alexclunan/impedance-analyzer/docs/archive/legacy-plans/memory__MEMORY.md

# Memory Index

- [full_design.bd known non-issues](full-design-bd-known-nonissues.md) — DAC dac_data_y unused & ADC capture-clock CDC are intentional; don't re-flag
