alexclunan/impedance-analyzer/Block Diagrams/FPGA_simplified.png

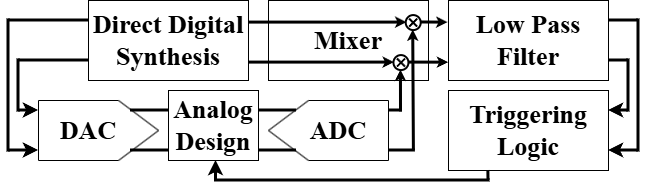
Block Diagrams/FPGA_simplified.png
