alexclunan/impedance-analyzer/Block Diagrams/Top-Level-Architecture-v0.png

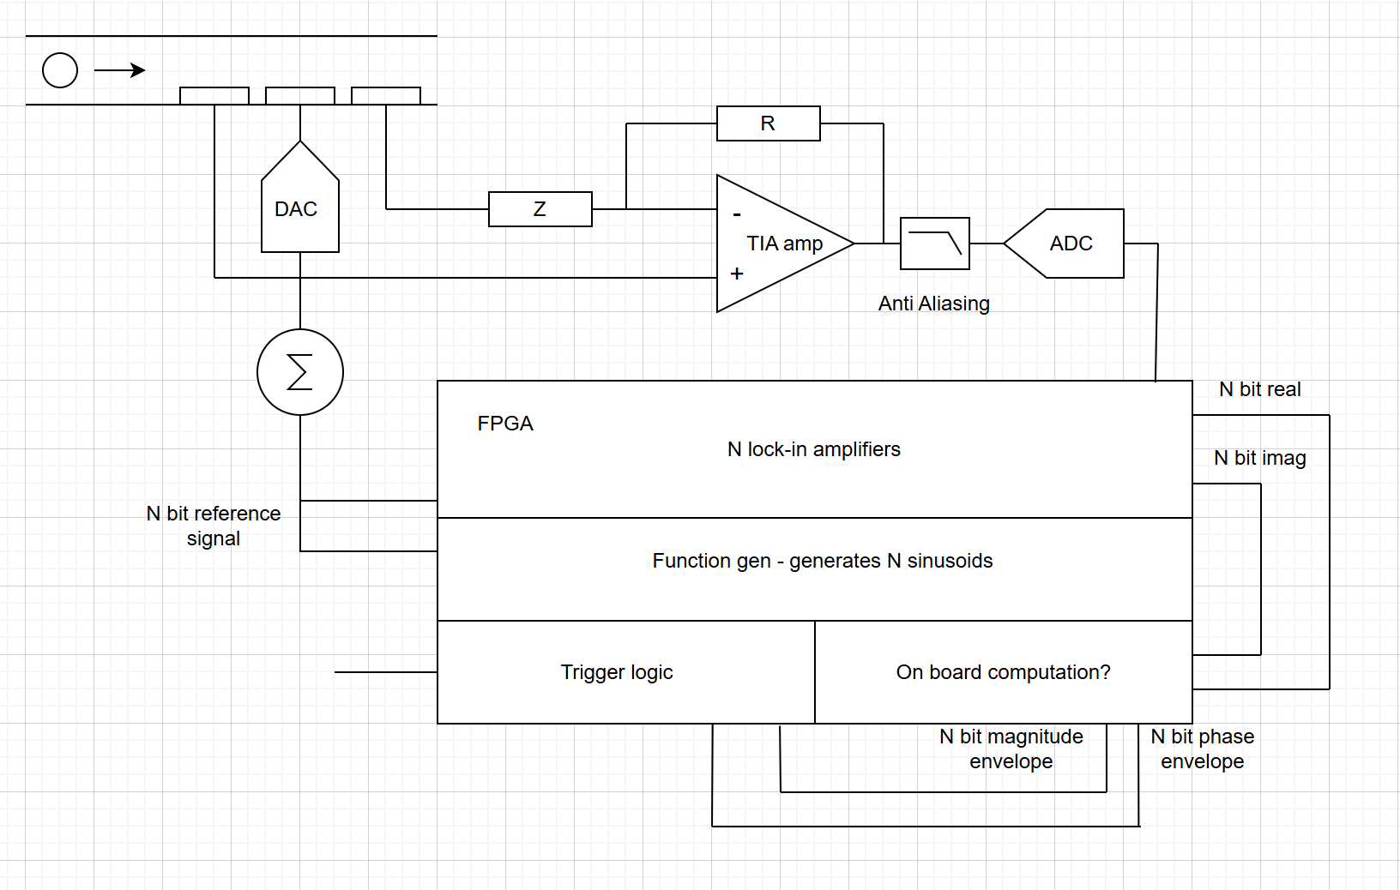
Block Diagrams/Top-Level-Architecture-v0.png
