alexclunan/impedance-analyzer/pc/adc2_spectrum.png

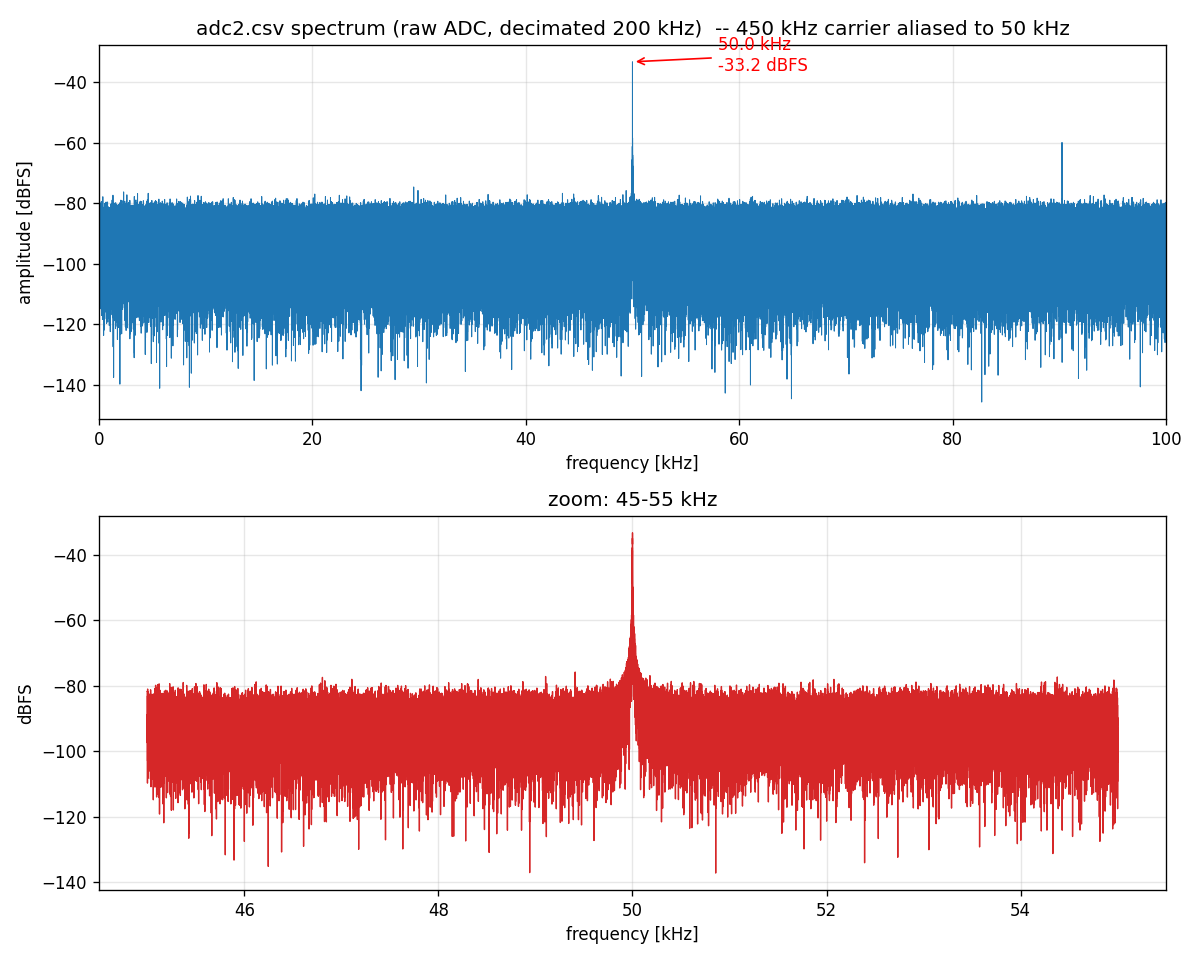
pc/adc2_spectrum.png
