alexclunan/impedance-analyzer/docs/archive/legacy-plans/verification_plans__05_triggering_TODO.md

# 05 — Triggering RTL Block

**Status: DEFERRED.**

The trigger logic (impedance amplitude + phase → sorting decision) already exists as a Python script from a separate project. It will be translated to RTL in a later phase.

No design, approach, or interface recommendations are made at this stage. This document is a placeholder; a full implementation plan will be written when the translation is taken up.

**TODO:** Translate existing Python triggering script to RTL.
