alexclunan/impedance-analyzer/PCB/PCB Schematic.pdf

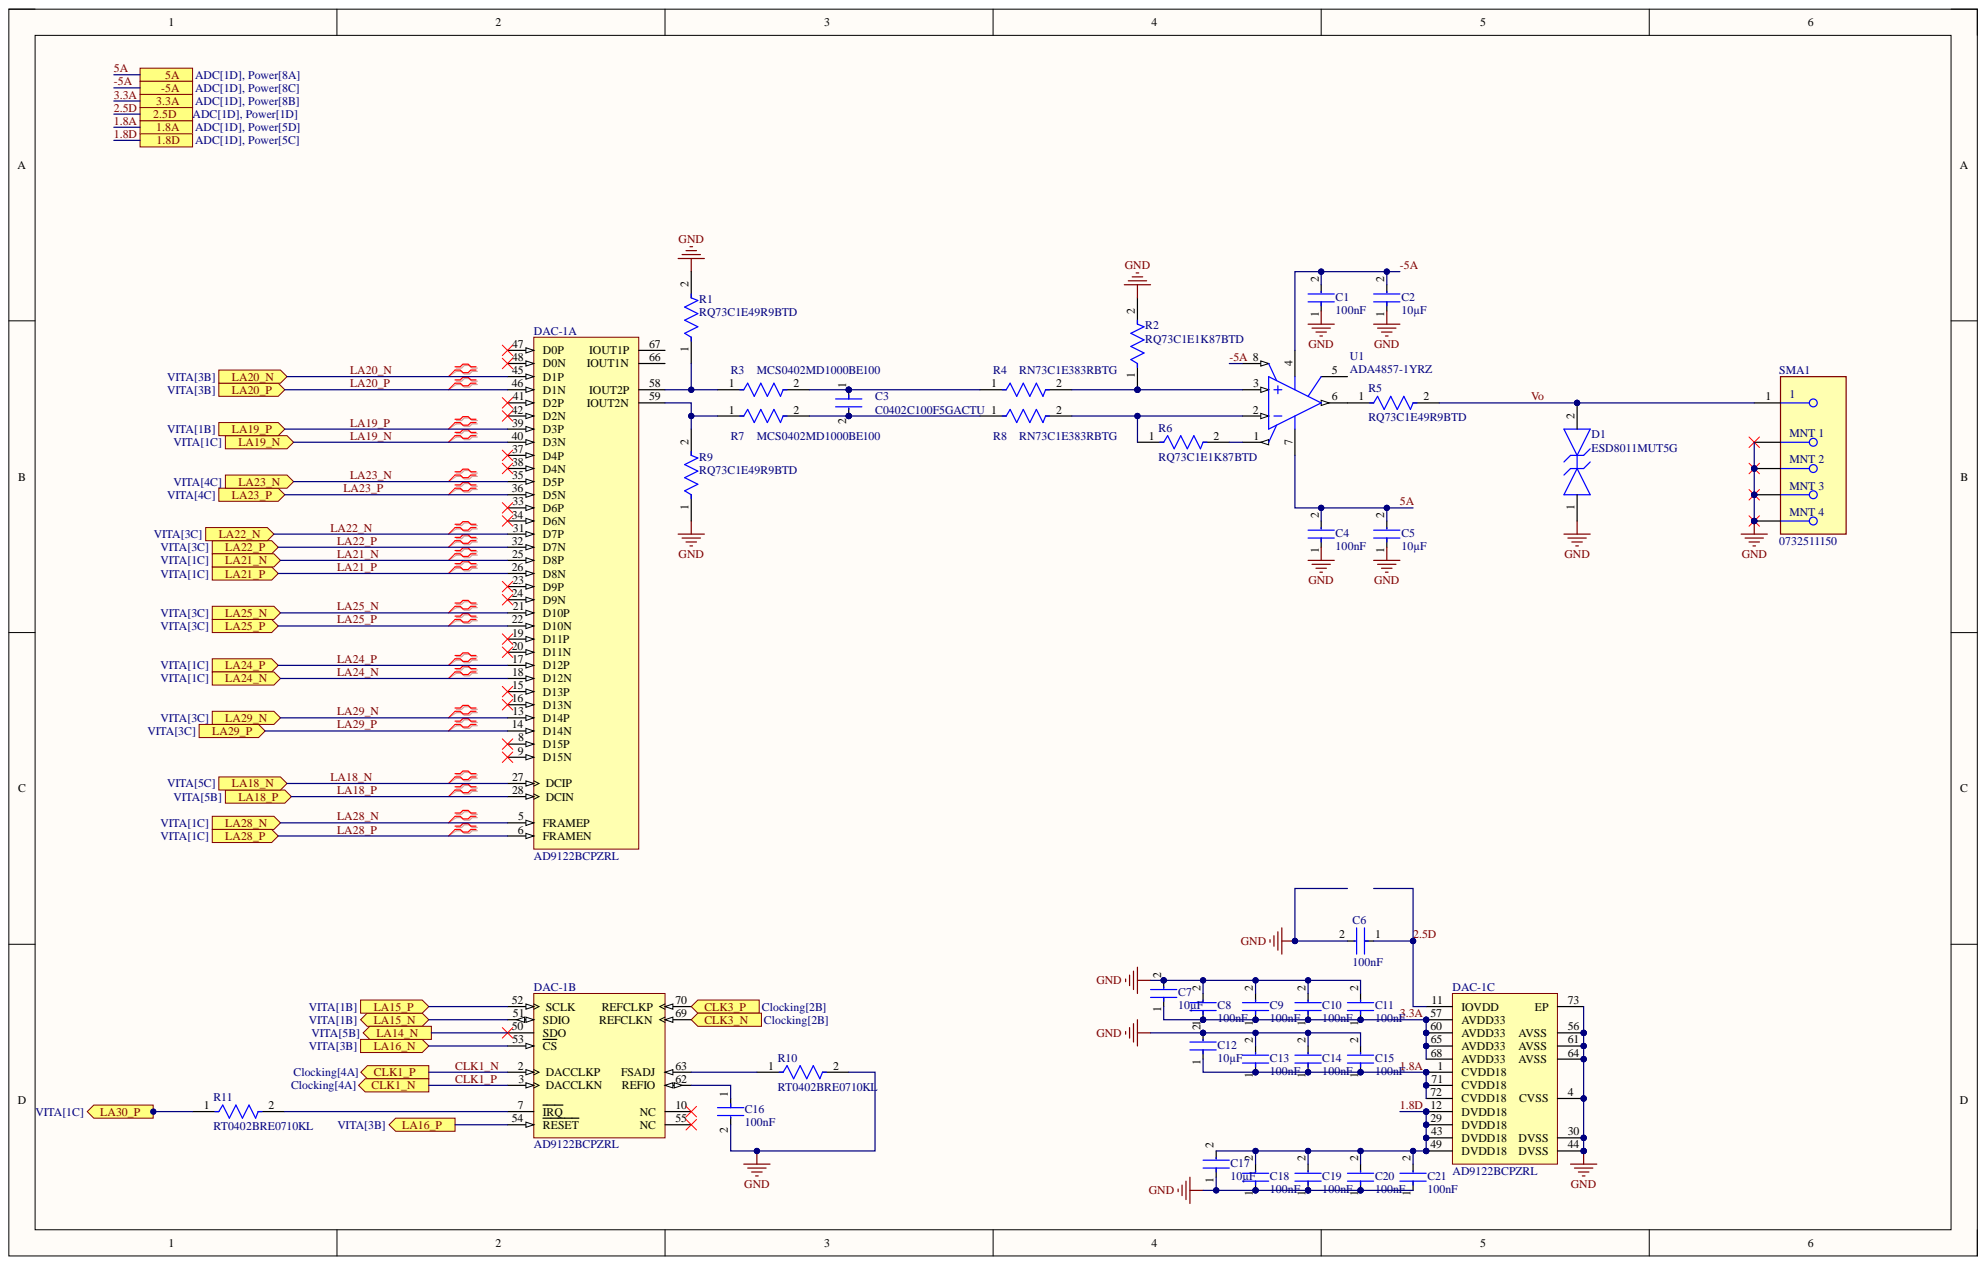
[picture p8: page 1]

6 5 | 6 1
6 8 | 6 4

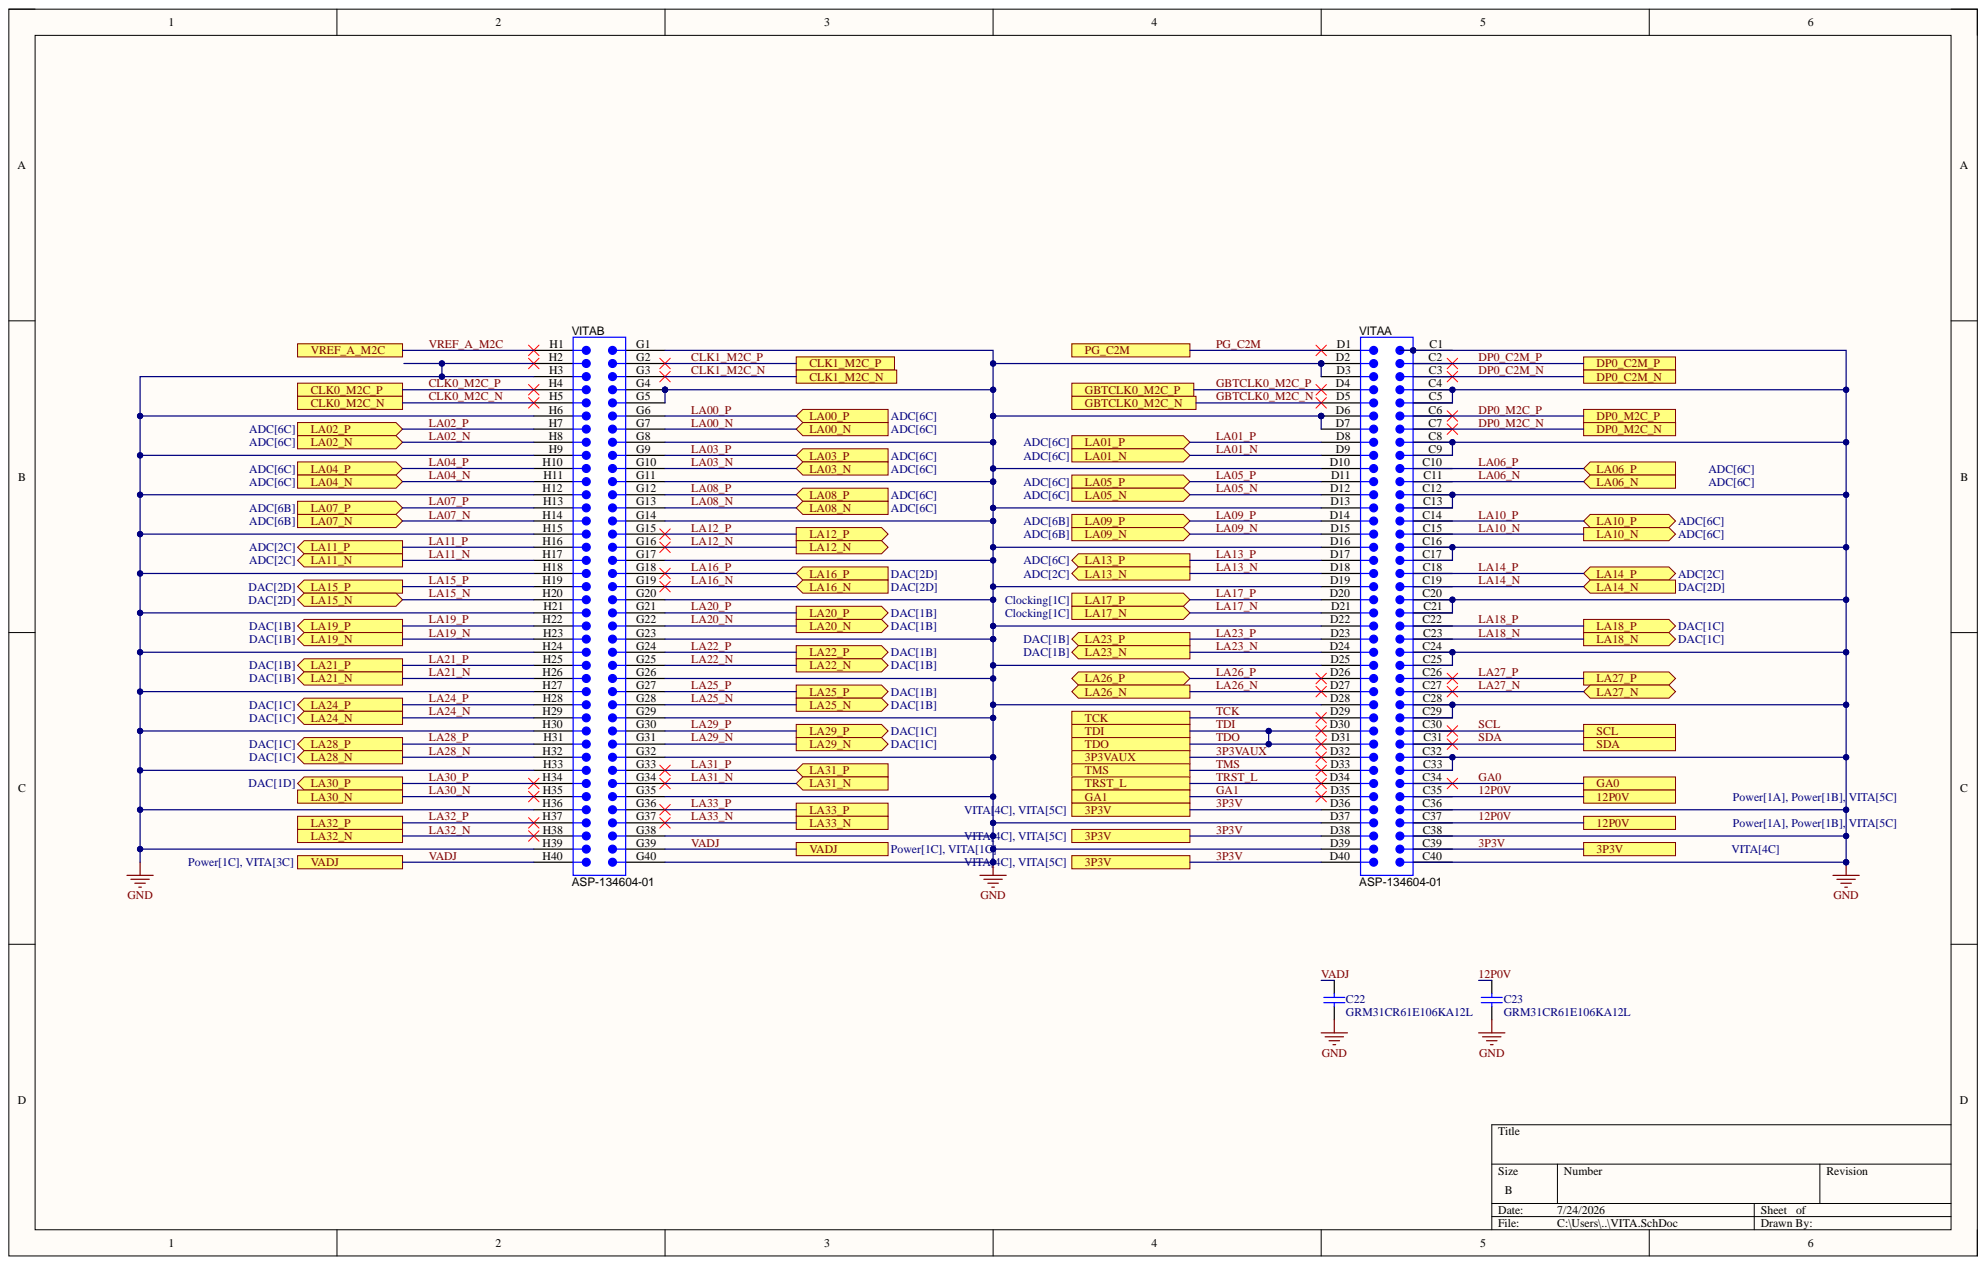
[picture p9: page 2]

H3 | G3 | CLK1 _M2C_ N | CLK1 _M2 C _ P | D3 | C3 DP0 _C2 M _N | DP0 _C2 M _ P

CLK1 _M2C_ N | | | DP0 _C2 M _N

LA2 8 _ P H3 1 DAC[1C] LA2 8 _ P DAC[1C] LA2 8 _N | G3 1 LA2 9 _N | TDO 3P3VAUX | D3 1 | C3 1 SDA | SDA

LA3 0 _ P H3 4 DAC[1D] LA3 0 _ P | | G3 4 LA3 1 _N | | TM S | TRST_ L D3 4 | | C3 4 GA0 12P0 Power[1A], Power[1B], VI

TRST_ L | | | | GA0 12P0

LA3 2 _ P H3 7 | | G3 7 LA3 3 _N | | | | | GA1 3P3V 3P3V 3P3V D3 7 | | C3 7 1 2P0 V Power[1A], Power[1B], VI

LA3 2 _ P | LA3 2 _N H3 8 | | G3 8 | LA3 3 _N | | D3 8 | | C3 8 | 1 2P0 V
LA3 2 _N | | | VI G3 9 VADJ Power[1C], VI TA[1C] | | 3P3 V | | | C3 9 3P3 V VI TA[4C]

VADJ | VADJ | H4 0 | | G4 0 | | 3P3 V | D4 0 | | C4 0

VADJ | | | | | 3P3 V

Size B | Number | Revisio n

Date: 7/2 4/2 0 2 6 | Sheet o f
File: C:\Users\..\VI TA.SchDo c | Drawn By :

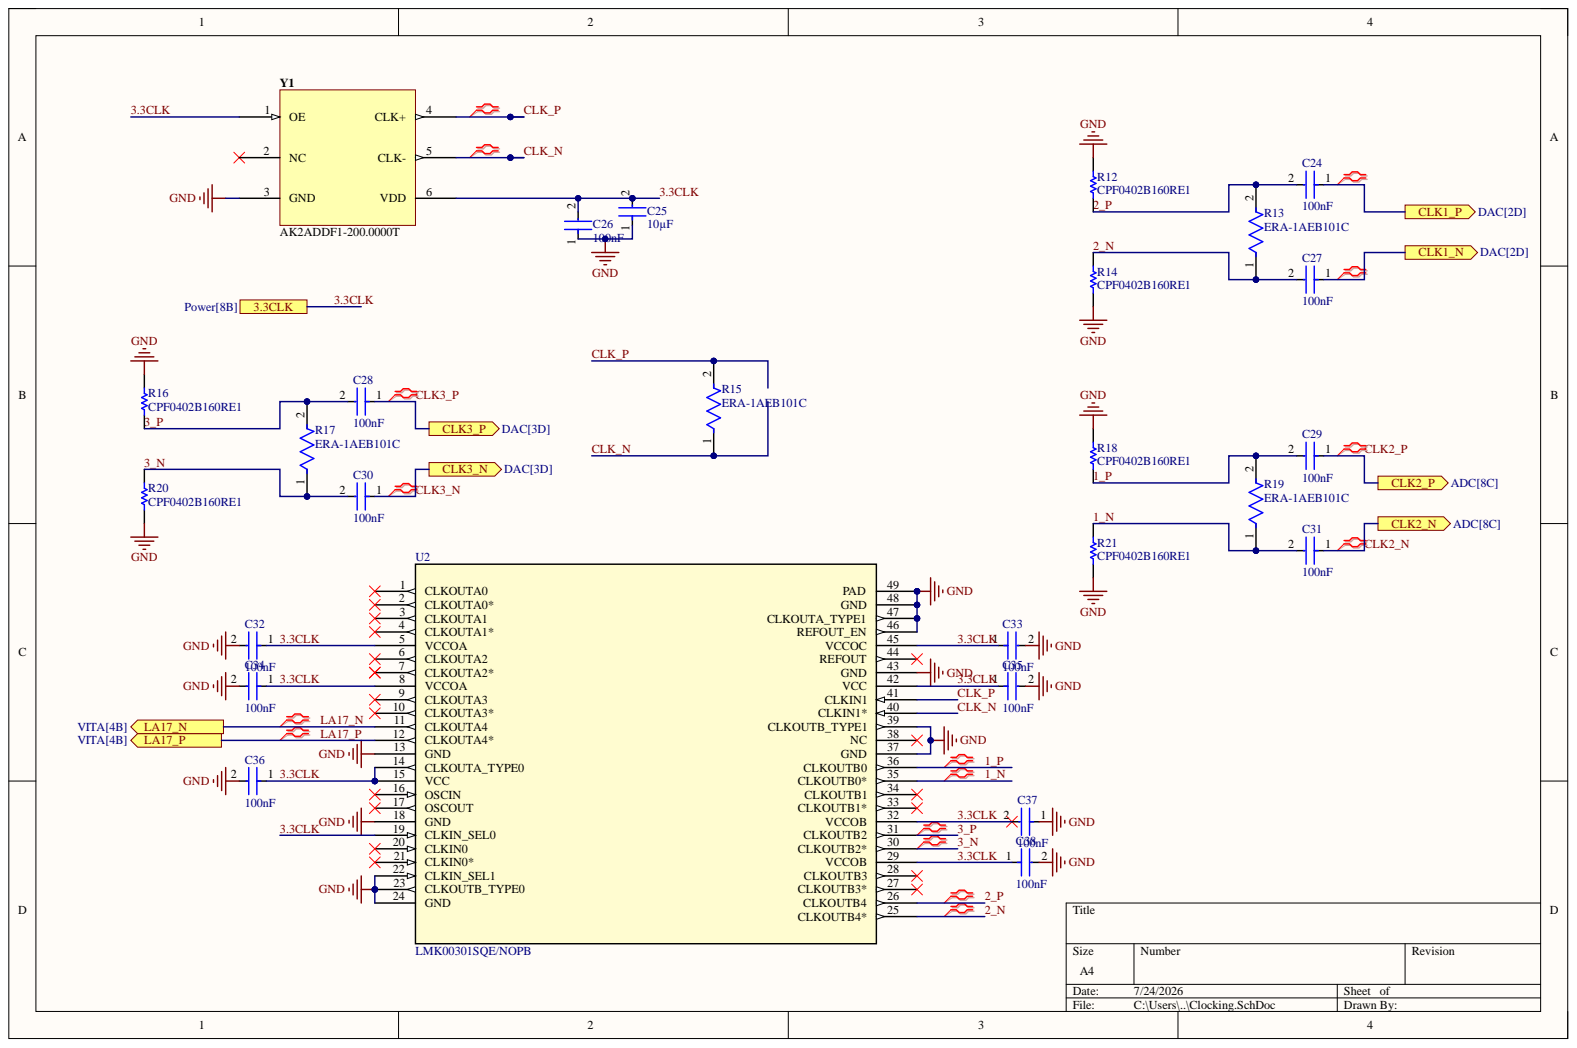
[picture p10: page 3]

GND GND

Date: 7/24/2026 | Sheet of
File: C:\Users\..\Clocking.SchDoc | Drawn By:

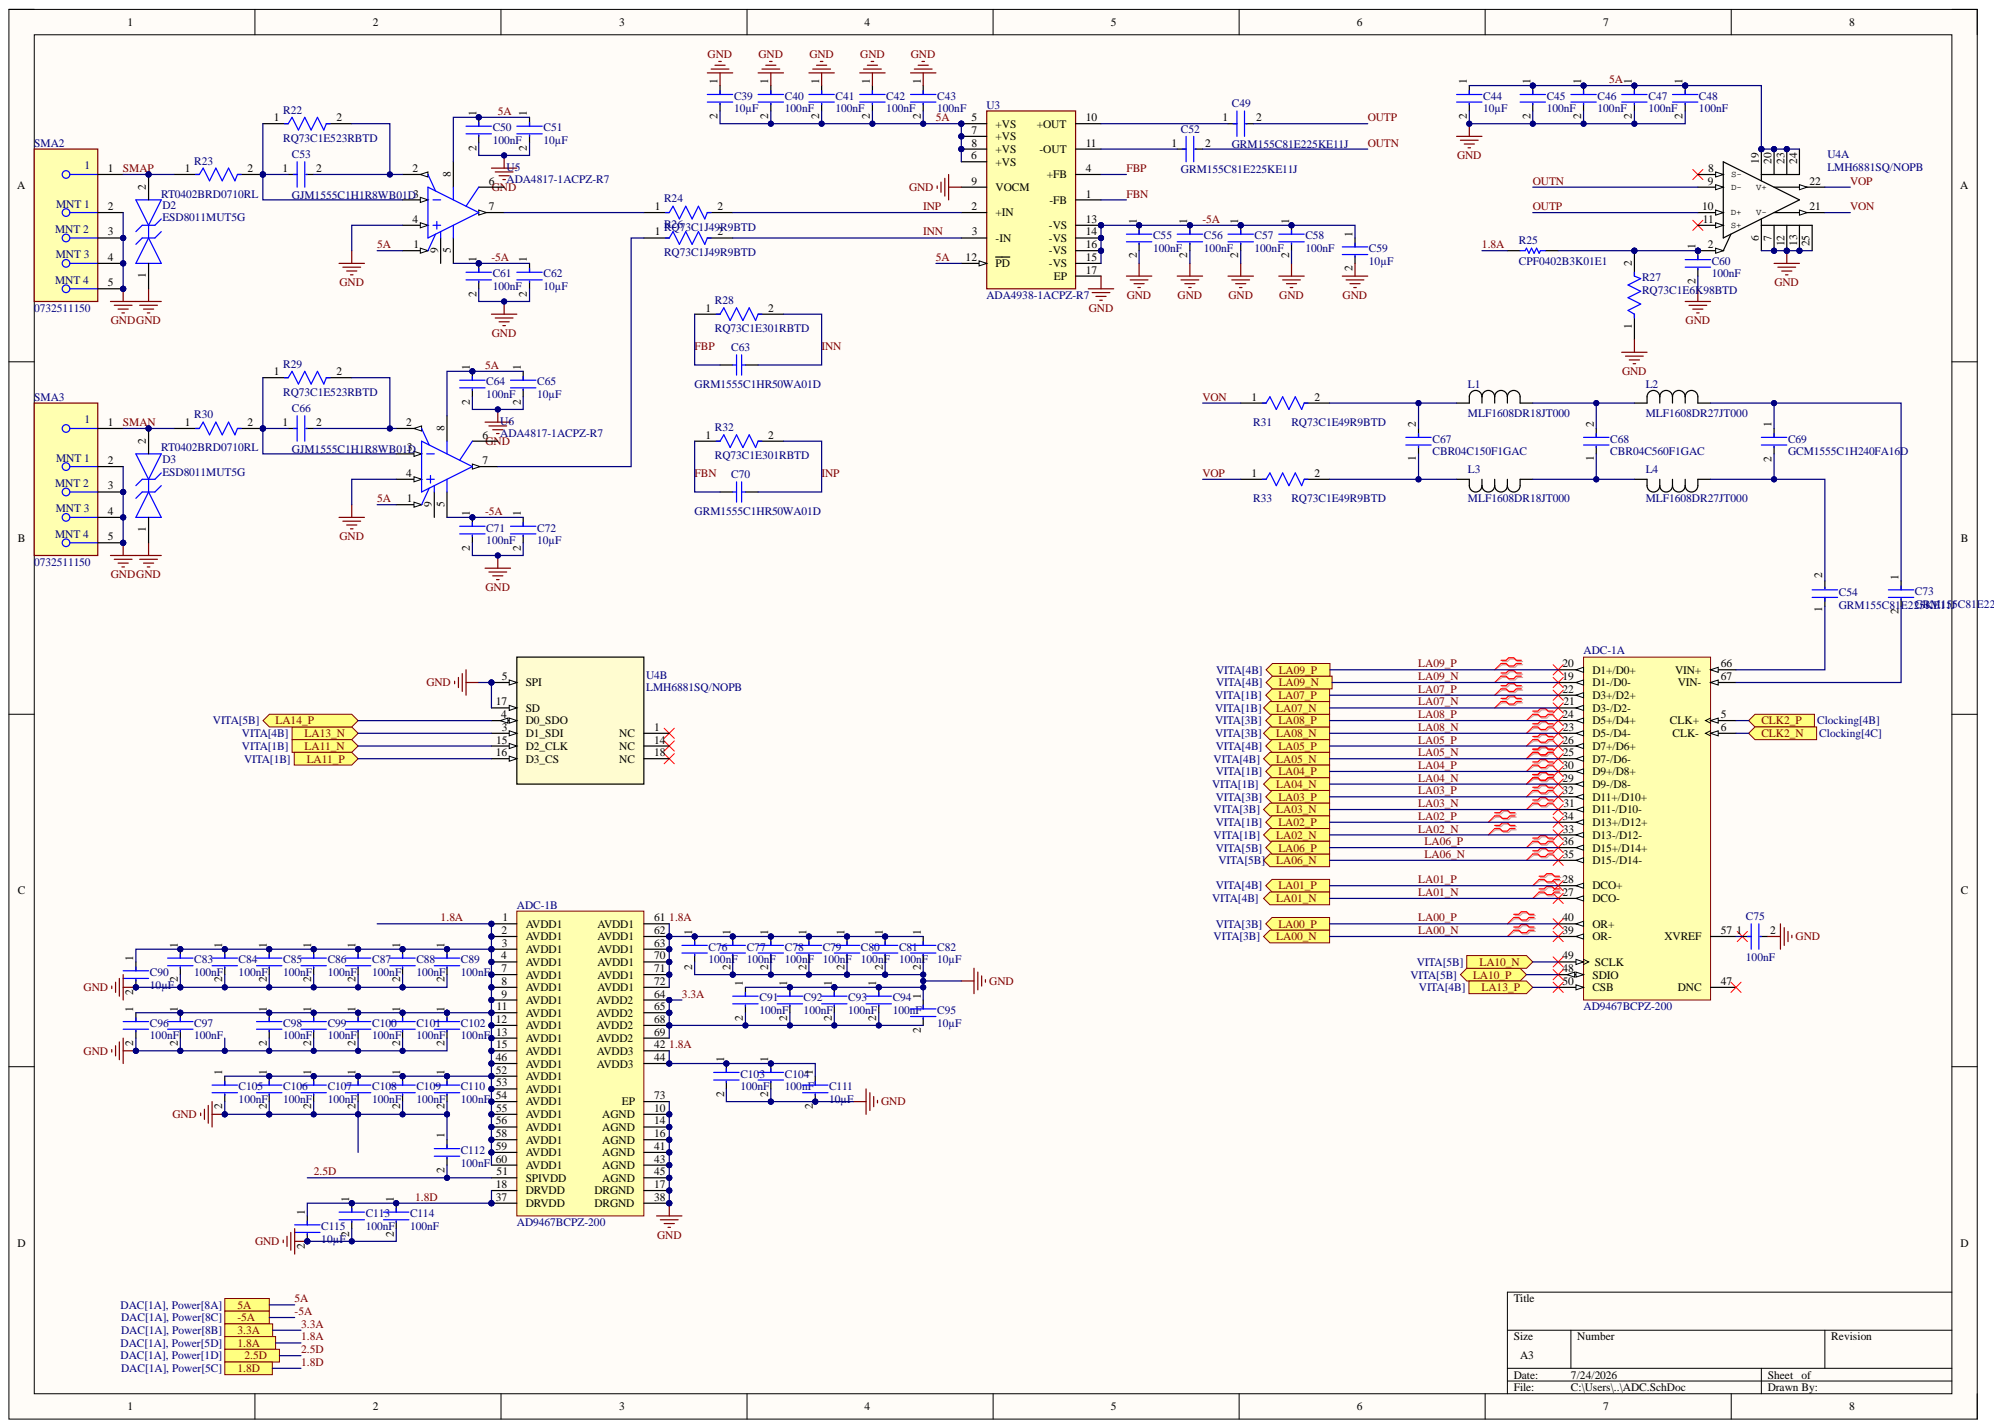
[picture p11: page 4]

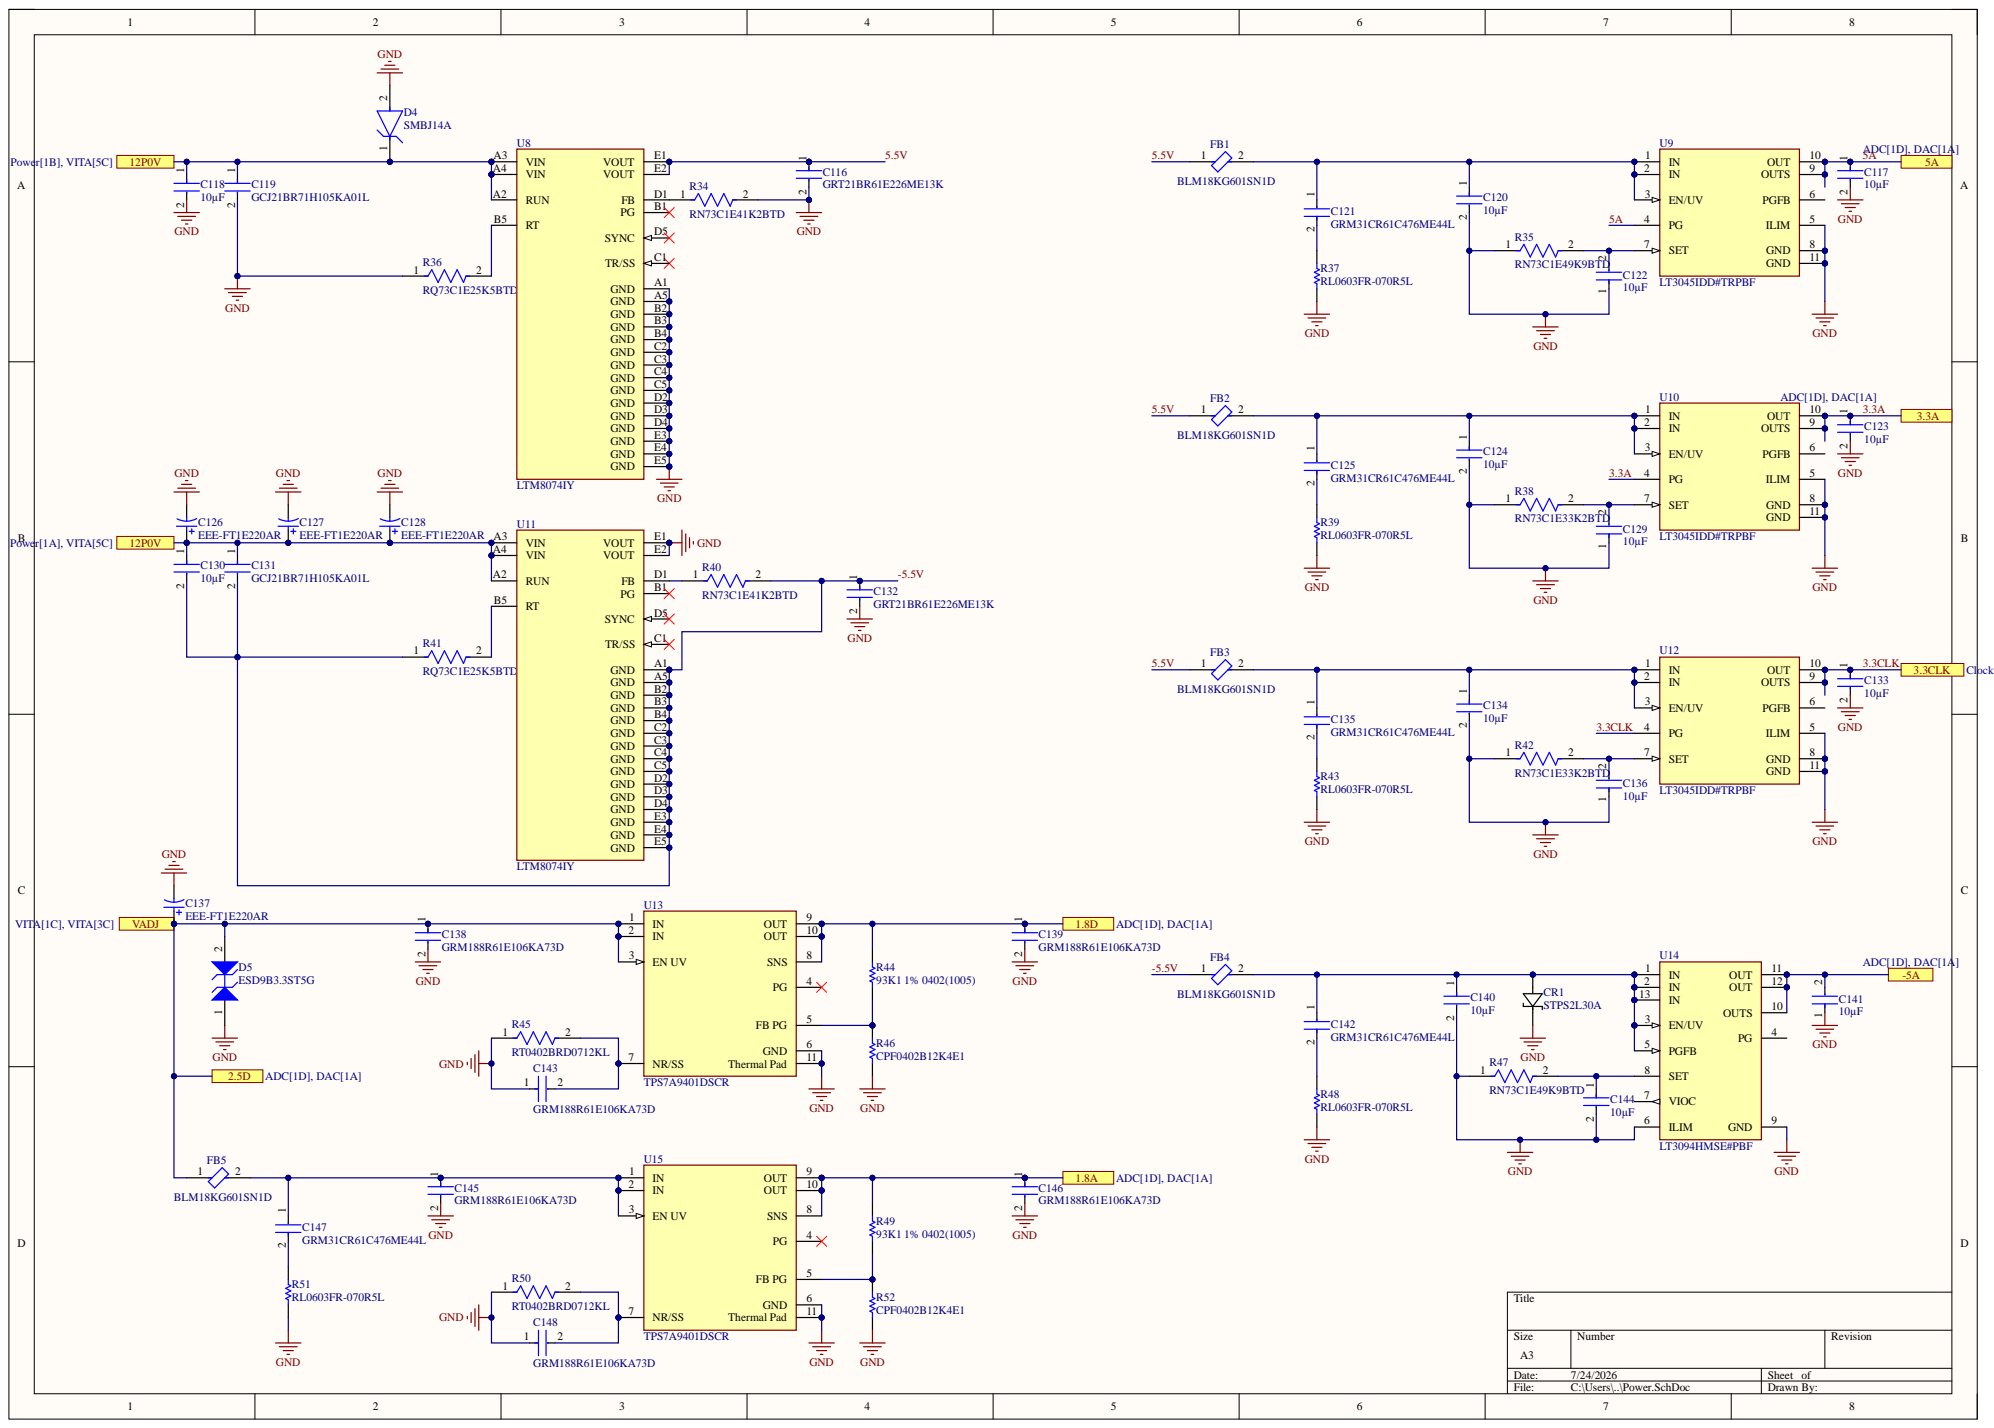
[picture p12: page 5]

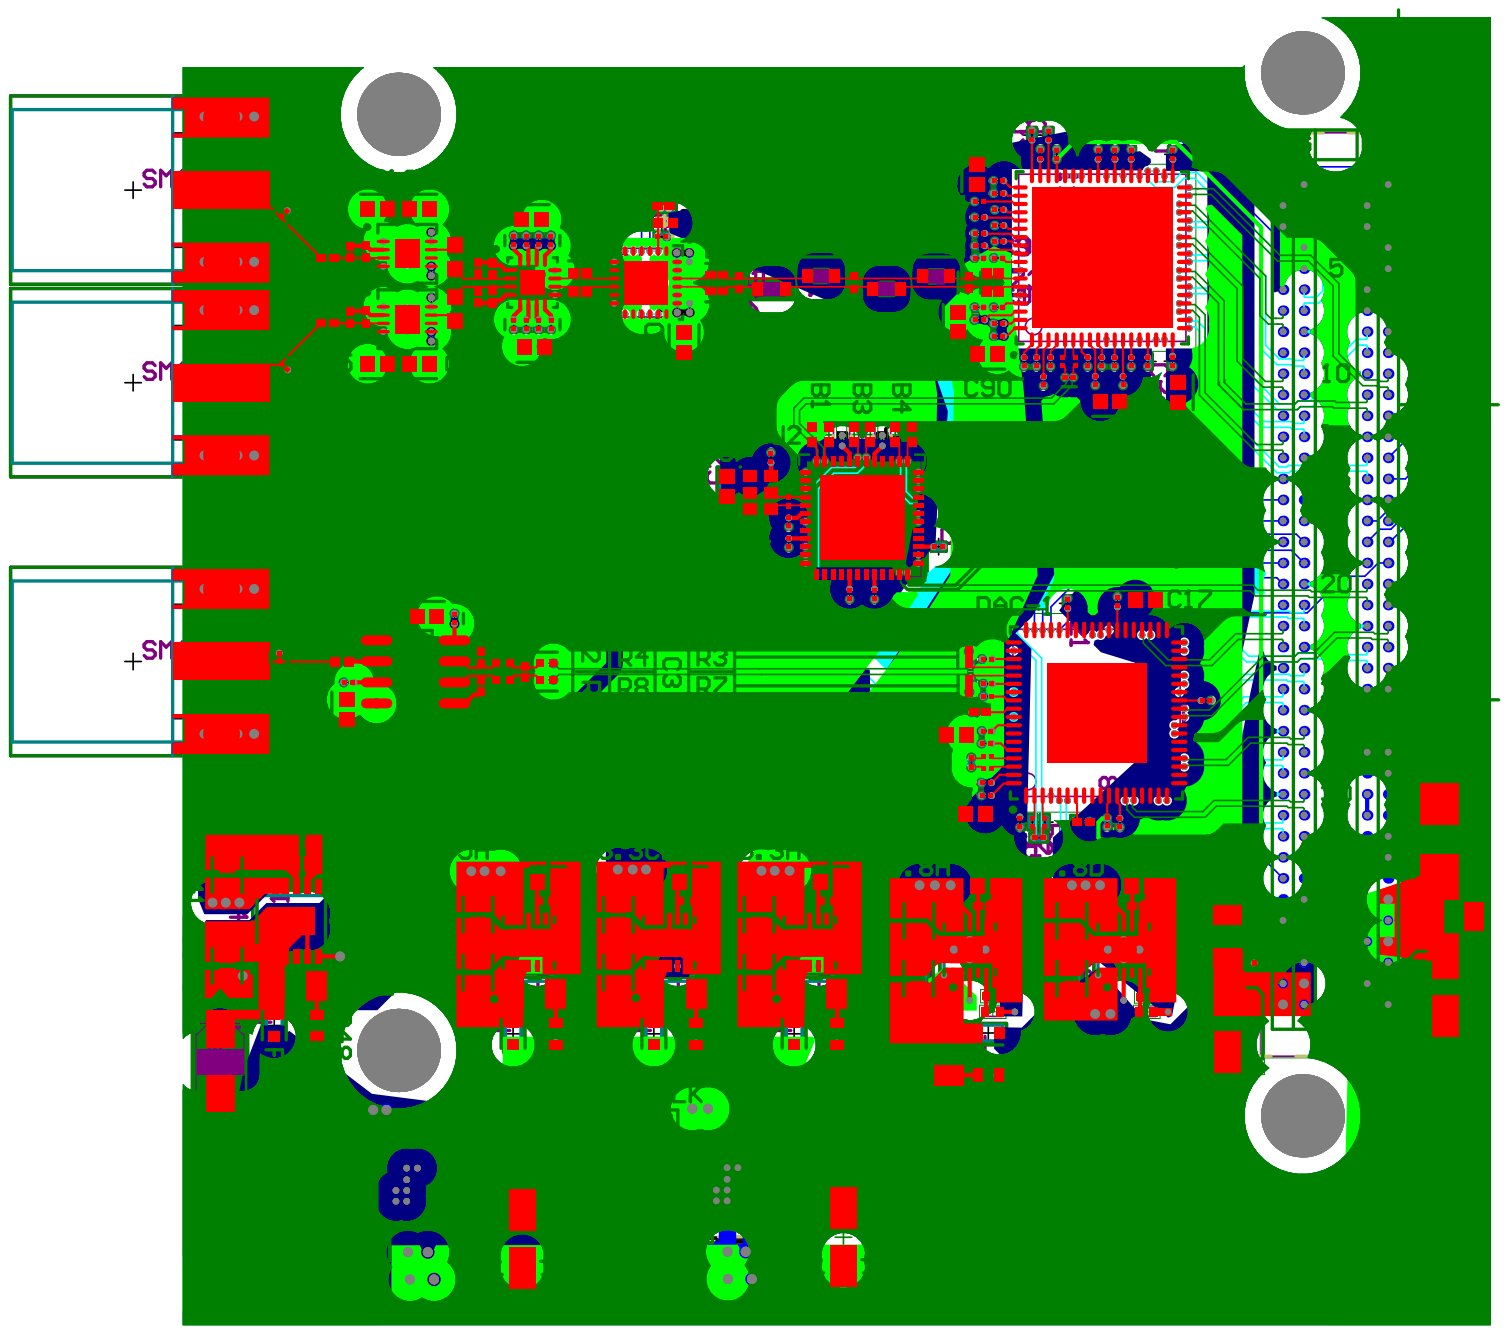
[picture p13: page 6]
