alexclunan/impedance-analyzer/pc/iza_gui/register_panel.py

"""register_panel.py — the Registers tab.

One compact table per device (FPGA / DAC AD9122 / ADC AD9467) listing every
documented register: address, name, live value, and a per-row refresh button.
Editing a value cell and pressing Enter writes the register (then reads it
back).  Hovering a value shows the decoded bitfields; hovering a name shows
the register's description.

Update policy (per user spec): all registers are read once when the board is
connected; after that a register is re-read only when (a) a GUI command that
affects it completes, (b) its row refresh button is clicked, or (c) a
device-wide "Read all" is requested.
"""

from pyqtgraph.Qt import QtCore, QtGui, QtWidgets

from . import register_map as rm
from . import theme
from .widgets import CollapsibleSection

_DEVICES = ("fpga", "dac", "adc")
_REGS = {"fpga": rm.FPGA_REGS, "dac": rm.DAC_REGS, "adc": rm.ADC_REGS}
_HEXW = {"fpga": 8, "dac": 2, "adc": 2}     # value width in hex digits

COL_ADDR, COL_NAME, COL_VAL, COL_BTN = range(4)


def _reader(dev, ctrl, addr):
    if dev == "fpga":
        return ctrl.reg_read(addr)
    if dev == "dac":
        return ctrl.dac_read(addr)
    return ctrl.adc_read(addr)


def _writer(dev, ctrl, addr, val):
    if dev == "fpga":
        ctrl.reg_write(addr, val)
    elif dev == "dac":
        ctrl.dac_write(addr, val)
    else:
        ctrl.adc_write(addr, val)
    return _reader(dev, ctrl, addr)          # read back the result


class _RegTable(QtWidgets.QTableWidget):
    """Compact register table for one device."""

    write_requested = QtCore.Signal(int, int)    # (addr, value)
    refresh_requested = QtCore.Signal(int)       # (addr)

    def __init__(self, dev, parent=None):
        regs = _REGS[dev]
        super().__init__(len(regs), 4, parent)
        self.dev = dev
        self.regs = {r.addr: r for r in regs}
        self._row_of = {r.addr: i for i, r in enumerate(regs)}
        self._updating = False

        self.setHorizontalHeaderLabels(["Addr", "Register", "Value", ""])
        self.verticalHeader().setVisible(False)
        self.verticalHeader().setDefaultSectionSize(22)
        self.setShowGrid(False)
        self.setAlternatingRowColors(True)
        self.setSelectionMode(QtWidgets.QAbstractItemView.NoSelection)
        self.setEditTriggers(QtWidgets.QAbstractItemView.DoubleClicked
                             | QtWidgets.QAbstractItemView.SelectedClicked
                             | QtWidgets.QAbstractItemView.AnyKeyPressed)
        self.setVerticalScrollBarPolicy(QtCore.Qt.ScrollBarAlwaysOff)
        self.setHorizontalScrollBarPolicy(QtCore.Qt.ScrollBarAlwaysOff)
        self.setFocusPolicy(QtCore.Qt.ClickFocus)

        mono = QtGui.QFont("Consolas")
        for i, r in enumerate(regs):
            a = QtWidgets.QTableWidgetItem(f"0x{r.addr:02X}")
            a.setFont(mono)
            a.setFlags(QtCore.Qt.ItemIsEnabled)
            n = QtWidgets.QTableWidgetItem(r.name)
            n.setFlags(QtCore.Qt.ItemIsEnabled)
            v = QtWidgets.QTableWidgetItem("—")
            v.setFont(mono)
            if r.writable:
                v.setFlags(QtCore.Qt.ItemIsEnabled | QtCore.Qt.ItemIsEditable
                           | QtCore.Qt.ItemIsSelectable)
            else:
                v.setFlags(QtCore.Qt.ItemIsEnabled)
                v.setForeground(QtGui.QColor(theme.TEXT_DIM))
            tip = rm.layout_tooltip(r)
            for it in (a, n, v):
                it.setToolTip(tip)
            self.setItem(i, COL_ADDR, a)
            self.setItem(i, COL_NAME, n)
            self.setItem(i, COL_VAL, v)

            btn = QtWidgets.QToolButton()
            btn.setText("⟳")
            btn.setToolTip(f"Re-read {r.name} from the board")
            btn.setAutoRaise(True)
            btn.clicked.connect(
                lambda _c=False, addr=r.addr: self.refresh_requested.emit(addr))
            self.setCellWidget(i, COL_BTN, btn)

        hh = self.horizontalHeader()
        hh.setSectionResizeMode(COL_ADDR, QtWidgets.QHeaderView.ResizeToContents)
        hh.setSectionResizeMode(COL_NAME, QtWidgets.QHeaderView.Stretch)
        hh.setSectionResizeMode(COL_VAL, QtWidgets.QHeaderView.ResizeToContents)
        hh.setSectionResizeMode(COL_BTN, QtWidgets.QHeaderView.ResizeToContents)
        self.setMinimumWidth(360)
        self._fit_height()

        self.itemChanged.connect(self._on_item_changed)

    def _fit_height(self):
        h = self.horizontalHeader().height() + 4
        for i in range(self.rowCount()):
            h += self.rowHeight(i)
        self.setFixedHeight(h)

    # ---- value display ----------------------------------------------------
    def set_value(self, addr, value):
        """Show a freshly read value (None = read failed)."""
        row = self._row_of.get(addr)
        if row is None:
            return
        item = self.item(row, COL_VAL)
        reg = self.regs[addr]
        self._updating = True
        try:
            if value is None:
                item.setText("?")
                item.setToolTip("(read failed)\n\n" + rm.layout_tooltip(reg))
            else:
                item.setText(f"0x{value:0{_HEXW[self.dev]}X}")
                tip = rm.decode_tooltip(reg, value)
                if not reg.writable:
                    tip += "\n(read-only — cannot be set)"
                item.setToolTip(tip)
        finally:
            self._updating = False

    def mark_stale(self):
        """Grey every value (link lost / not yet read)."""
        self._updating = True
        try:
            for i in range(self.rowCount()):
                self.item(i, COL_VAL).setText("—")
        finally:
            self._updating = False

    # ---- edits ------------------------------------------------------------
    def _on_item_changed(self, item):
        if self._updating or item.column() != COL_VAL:
            return
        row = item.row()
        addr = int(self.item(row, COL_ADDR).text(), 16)
        try:
            val = int(item.text().strip(), 0)
        except ValueError:
            self.set_value(addr, None)
            return
        maxv = (1 << (4 * _HEXW[self.dev])) - 1
        self.write_requested.emit(addr, val & maxv)
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
