alexclunan/impedance-analyzer/pc/iza_gui/scope_panel.py

"""scope_panel.py — live pyqtgraph scope with LabOne-style customization.

Ported from iza_plotter.py: a magnitude/value plot, a phase plot, and (when the
raw-ADC monitor is enabled) an ADC time series + live dBFS spectrum.  Adds:
  * value select — Magnitude / X (in-phase) / Y (quadrature)
  * per-channel show/hide, normalize, lin/log Y, adjustable time window + decimation
  * two draggable cursors with a delta readout
  * a math trace: chA {ratio, diff, dB} chB
"""

import time

import numpy as np
import pyqtgraph as pg
from pyqtgraph.Qt import QtCore, QtWidgets

import iza_packet as izp
from . import data_stream as ds
from . import theme
from .widgets import labeled_row

TARGET_PTS = 4000           # points per trace the auto-decimator aims for
                            # (a screen shows ~1-2k px wide; more just burns CPU)
SAFETY_PTS = 200000         # absolute per-trace cap (manual decimation only)
NFFT = 8192
ADC_FULLSCALE = 32768.0
FFT_PERIOD_S = 0.25         # recompute the spectrum at most this often


class _PlotPopout(QtWidgets.QWidget):
    """A standalone window that hosts one relocated PlotItem. The plot keeps
    updating live because redraw() writes to its curves regardless of which
    scene shows them. Closing the window returns the plot to the main stack."""
    closed = QtCore.Signal(str)

    def __init__(self, key, title):
        super().__init__()
        self._key = key
        self.setWindowTitle(title)
        self.resize(860, 480)
        lay = QtWidgets.QVBoxLayout(self)
        lay.setContentsMargins(2, 2, 2, 2)
        self.glw = pg.GraphicsLayoutWidget()
        lay.addWidget(self.glw)

    def closeEvent(self, e):
        self.closed.emit(self._key)
        super().closeEvent(e)
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
