alexclunan/impedance-analyzer/(commit log)

2026-02-04 Signal Chain Simulator v0.1
    Initial creation of a tool for simulating component errors. The current setup is somewhat primitive and needs improvement.
    [dlia_signal_chain_gui.py, generators.py, input_signal.py, simulators.py, test_impedance_analyzer_chain.py]
2026-02-06 Vivado Project and Reference Materials
    [bsp.cfg]
2026-02-24 Vivado Project, More Reference, Architecture Update
    [Configuration_Register.h, VITA57_FMC_HPC_LPC_SIGNALS_AND_PINOUT.xlsx, bsp.cfg]
